manfredojuanignacio08-prog/Proyecto-Final-Reciclaje-y-Recoleccion-Inteligente/Documentación/Póster Campaña de Reciclaje Ilustrado Verde.jpg

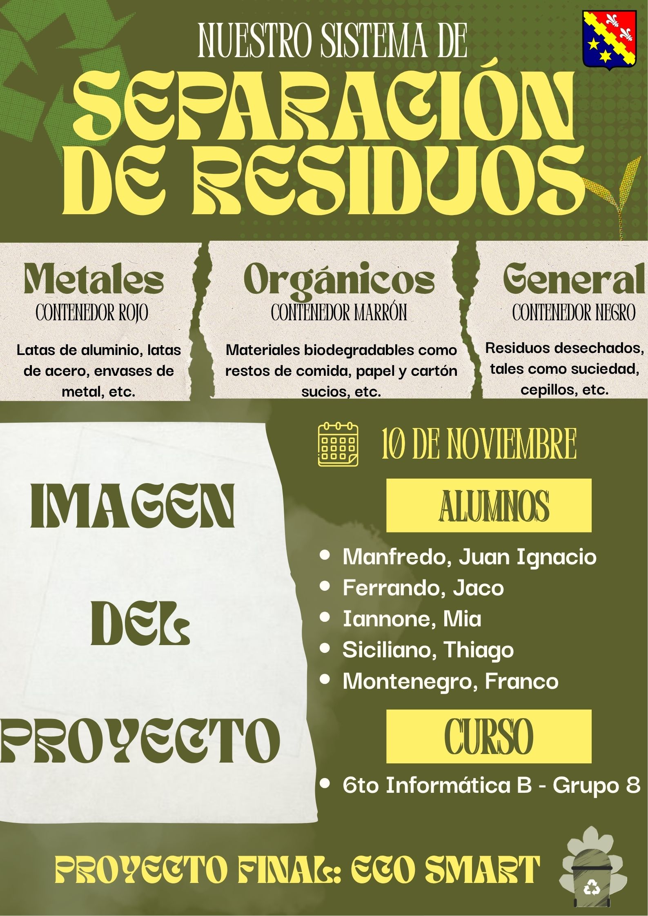
Documentación/Póster Campaña de Reciclaje Ilustrado Verde.jpg
