manfredojuanignacio08-prog/Proyecto-Final-Reciclaje-y-Recoleccion-Inteligente/README.md

# Proyecto-Final-Reciclaje-y-Recoleccion-Inteligente
# EcoSmart: reciclaje inteligente, datos reales, impacto visible

EcoSmart es un sistema automático que reconoce, separa y mide los residuos para ayudarte a gestionar mejor tus tachos. Funciona en tiempo real: detecta el material, dirige cada ítem al contenedor correcto (Metal, Orgánico o Resto) y calcula el porcentaje de llenado de cada tacho. Cuando uno se acerca al límite, te avisa con luz y sonido, y además lo verás en un dashboard web claro y moderno, desde cualquier dispositivo.

Nuestro proyecto se enfoca en reducir desbordes, evitar vaciados innecesarios y optimizar el mantenimiento de espacios educativos, oficinas y edificios. Con EcoSmart pasás de “intuir” a decidir con datos: cuántos kilos se depositaron, qué tipo de material es más frecuente, cómo evolucionó el uso en los últimos días y cuándo conviene vaciar.

EcoSmart combina sensores confiables y una app simple de usar. Vos ves solo lo que necesitás: tarjetas por tacho con barras de progreso, indicadores clave (peso total, cantidad de depósitos, material más común), histórico y alertas configurables. Además, podés ajustar los parámetros (posiciones, velocidades, umbrales) sin herramientas especiales.

EcoSmart convierte el reciclaje en una experiencia simple, medible y efectiva. Instalalo, mirá el tablero y empezá a tomar decisiones que mejoran tu espacio… y el planeta.
