manfredojuanignacio08-prog/Proyecto-Final-Reciclaje-y-Recoleccion-Inteligente/Documentación/Póster Campaña de Reciclaje Ilustrado Verde.docx

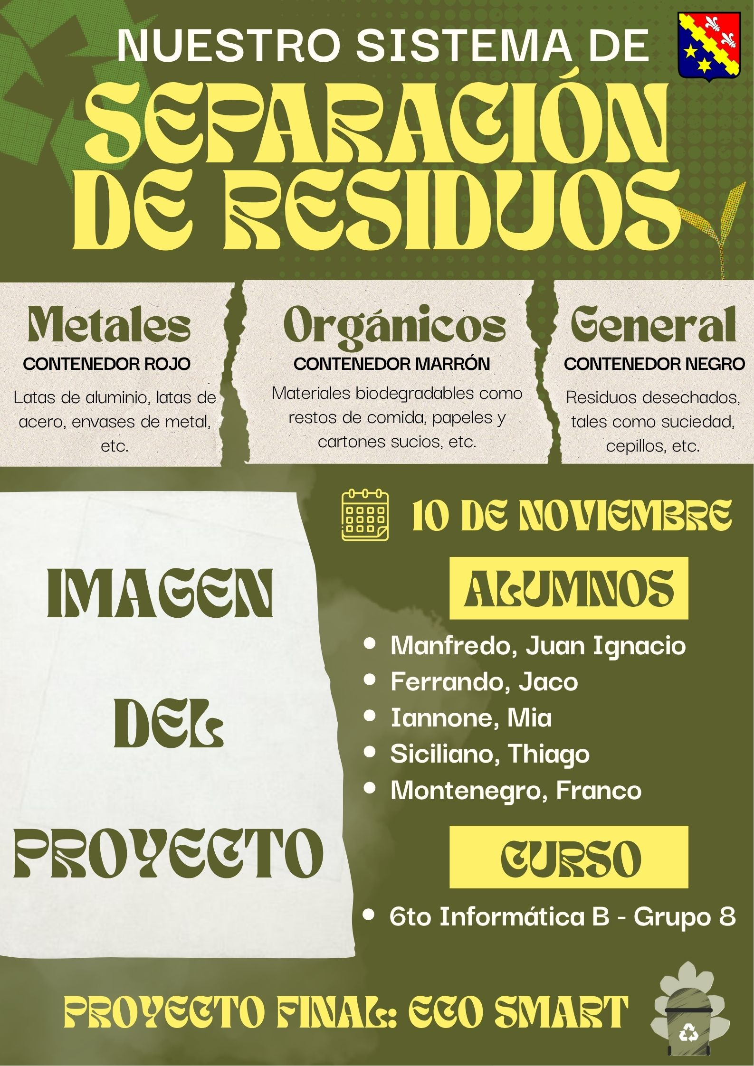
[picture p39: figure]
