manfredojuanignacio08-prog/Proyecto-Final-Reciclaje-y-Recoleccion-Inteligente/Documentación/Tabla de Precios - Manfredo, Ferrando, Iannone, Siciliano y Montenegro 3 (1).xlsx

Sheet: Precios Componentes
MATERIALES | CANTIDAD | PRECIO UNITARIO AR$ | CATEGORÍA | OBSERVACIONES | SUBTOTAL AR$ | TOTAL POR CATEGOÍA AR$
Pack 40 Cables Macho–Hembra 20cm | 2 | $4000.00 | Cables | - | $8000.00 | $18000.00
Pack 40 Cables Macho–Macho 10cm | 1 | $3000.00 | Cables | - | $3000.00
Pack 40 Cables Macho-Macho 20cm | 1 | $4000.00 | Cables | - | $4000.00
Pack 40 Cables Hembra–Hembra 20cm | 1 | $3000.00 | Cables | - | $3000.00
Módulo IR Obstáculos (infrarrojo) | 1 | $770.00 | Sensores | Salida digital | $770.00 | $41273.00
Sensor Inductivo NPN LJ12A3-4-Z/BX (6–36V) | 1 | $6495.00 | Sensores | 12V + adaptación | $6495.00
SHT31 (Temp/Hum) I2C | 1 | $9364.00 | Sensores | I2C | $9364.00
Celda 5 kg + HX711 (x3) | 3 | $4620.00 | Sensores | - | $24644.00
Motor paso a paso 9V/12V | 1 | $0.00 | Actuadores | Carro de impresora | $0.00 | $6651.00
Servo SG92R Micro 9g 2.5kg 0.1s | 1 | $4592.00 | Actuadores | No se utilizará todo | $4592.00
Buzzer activo 5V | 1 | $687.00 | Actuadores | Con NPN + diodo | $687.00
NeoPixel Stick 8x WS2812 | 1 | $1372.00 | Actuadores | Level shifting a 5 V con HCT14 | $1372.00
Driver ULN2003 | 1 | $3000.00 | Módulos | Motor paso a paso | $3000.00 | $14159.00
RTC DS3231 + EEPROM 24C32 | 1 | $3554.00 | Módulos | I2C | $3554.00
PCA9685 16ch PWM I2C | 1 | $7605.00 | Módulos | Servos/LEDs | $7605.00
ESP32 NodeMCU WROOM-32 USB-C | 1 | $13940.00 | Control | - | $13940.00 | $13940.00
Fuente 5V 3A + Fuente reguladora | 1 | $0.00 | Alimentación | Brindado por pañol | $0.00 | $0.00
Protoboard | 2 | $5900.00 | Misceláneo | - | $11800.00 | $11800.00
Kit resistencias/capacitores | 1 | $0.00 | Misceláneo | Brindado por pañol | $0.00
Transistores NPN + relé | 1 | $0.00 | Misceláneo | Brindado por pañol | $0.00
 |  |  |  | TOTAL: | $105823.00
 |  |  |  | TOTAL (con envio): | $115823.00

Sheet: Precios Materiales No Hardware
MATERIALES | CANTIDAD | PRECIO UNITARIO AR$ | SUBTOTAL AR$
Tabla de Madera 50x50cm | 1 | $0.00 | $0.00
Caja de Exterior | 1 | $19500.00 | $19500.00
Caño PVC de 10 cm (1m) | 1 | $0.00 | $2250.00
Caño PVC de 1/2 pulgadas (10cm) | 1 | $500.00
Caño PVC de 1/2 pulgada (40cm) | 1 | $1000.00
Codo a 90º PVC de 1/2 pulgada | 1 | $250.00
Tapas ciegas para caño PVC de 1/2 pulgada | 2 | $500.00
Correa de impresora de 50cm + Polea + Agarre | 1 | $0.00 | $0.00
Kit tornillos, tuercas, arandelas, etc. | 1 | $0.00 | $0.00
Base acrílica transparente (1,46m x 13cm) | 1 | $0.00 | $0.00
 |  | TOTAL: | $21750.00

Sheet: Precios Total
 | SUBTOTAL AR$ | TOTAL AR$
Componentes del Hardware | $105823.00 | $127573.00
Materiales No Electrónicos | $21750.00
