manfredojuanignacio08-prog/Proyecto-Final-Reciclaje-y-Recoleccion-Inteligente/(list of files, drawings)

Other design files:
diagrama/Componentes/Arduino IR Obstacle Sensor Buzzer With LED.fzz
diagrama/Componentes/ESP32_Boards (1).fzz
diagrama/Componentes/Motors.fzz
diagrama/proyecto - otra version (1).fzz
